pab47/RoadRunner2/README.md

# RoadRunner2
All files related to RoadRunner2, a differential drive rimless wheel

Simulation
  Contains the derivation of simulation of the rimless wheel
    
Code
  Contains Arduino code library and Pi code 
  
Mechanical Design
  Contains solid works files of the different sub-assemblies of the robot.
