pab47/RoadRunner2/Code/README.txt

To install the software, please use the setup.txt file in the SETUP folder.
You will need to have the Arduino IDE installed.

To run the robot, call the following in the terminal:

python3 V5_angle_remote_controller.py
