pab47/RoadRunner2/Simulation/straight_walk_parameter_studies/read_me.rtf

April 17, 2019

1) run driver.m
this calls main to generate the data.

2) run parms_post_processing next to get the trends.
