pab47/RoadRunner2/Simulation/straight_walk_sim_expt/read_me.rtf

April 12, 2019

Comparing simulated data with experimental data for straight line walk for torso angle at 50 degree

Step 1: First run main.m to generate sim_data.mat

Step 2: Next run plotTestData_pab.m
This runs the file plotSimData.m (simulated data) and does experimental plots (this file)
The file plotSimData.m needs sim_data.mat that comes from simulations (step 1 here)

%%%%%%%%%

The columns are

1 time
2 pitch
3 setpoint
4 O drive Current
5 Pitch Rate
6
7 Absolute Velocity
8 Absolute position
9 Bus Voltage
10 Bus Current

Data to show
1) Velocity vs time (7)
2) Absolute position vs time
3) Current versus time

%%%%%%%%%
['curr_time'], ['feedback'], ['angle_cnt'], ['mapped_out'], ['pitchrate'], ['m1pos_deg'], ['m1speed'], ['m1beta'], ['vbus'], ['m1curr'], ['m0pos_deg'],['m0speed']

current time
feedback = what it reading from the imu in degrees
angle_cnt = PID setpoint in degrees
mapped_out = PID output in amps (what the ODrive takes as a desired current)
pitchrate = degrees/s
m1pos_deg
vbus = bus voltage on ODrive = battery voltage
m1 curr = current seen by motor1 (NOT a reliable value; includes imaginary current {the current has real and imaginary parts})

power = column 10 * column 9
O drive current is 4
m1speed
