pab47/RoadRunner2/Simulation/README.md

See descriptions within the files

  - RimlessWheel_Compliant_Derivation.m
	   Derives the sagittal plane model of the rimless wheel with compliant spokes.

  - folder straight_walk_parameter_studies
	  parameter studies 

  - folder straight_walk_sim_expt
	  straight walking compare simulation results with experimental data

  - folder straight_walk
	  straight motion only

  - folder turning_walk
	  turning motion only
