pab47/RoadRunner2/Mechanical_Design/Motor Assembly D.SLDASM

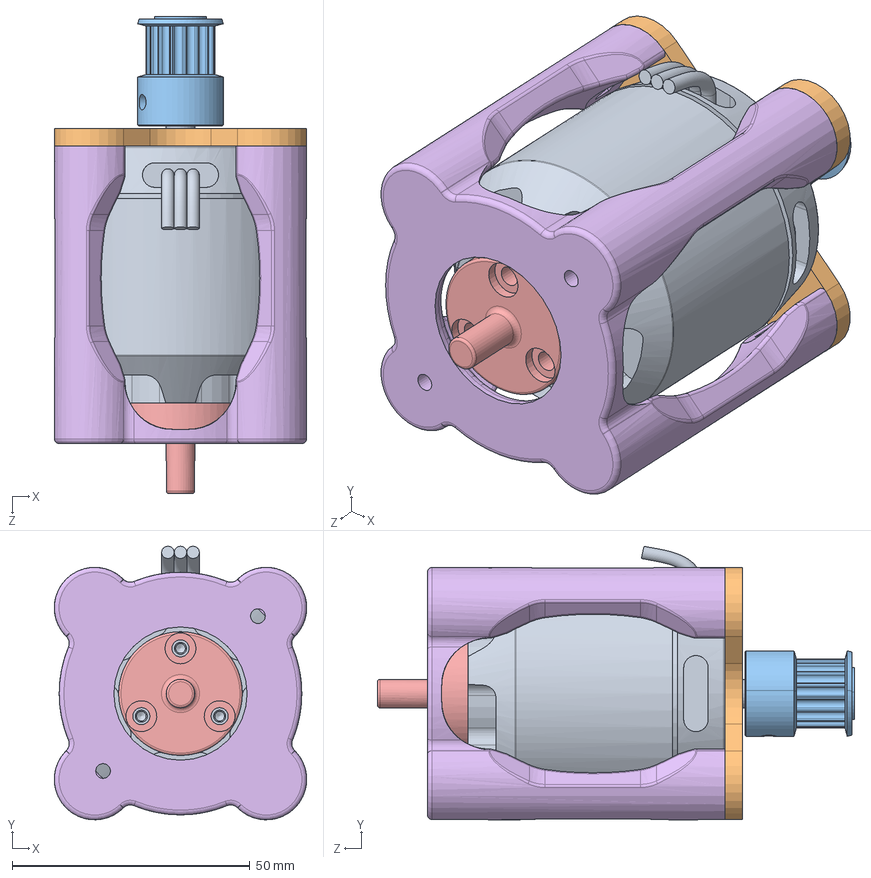
[picture p16: CAD file, 2019-10-29]
Mechanical_Design/Motor Assembly D.SLDASM
53.1 x 57.5 x 100.2 mm
Turnigy 5055 280
Motor Face Plate and Mount
_GPA16MR3090_K_P6_b_2
_SET_SCREW4_3_4 x 2
Screw on Encoder Shaft
Encoder Mount RevC
