pab47/RoadRunner2/Mechanical_Design/Parts/DP4UB-F100A42-B23PE-ACS/74-003.SLDASM

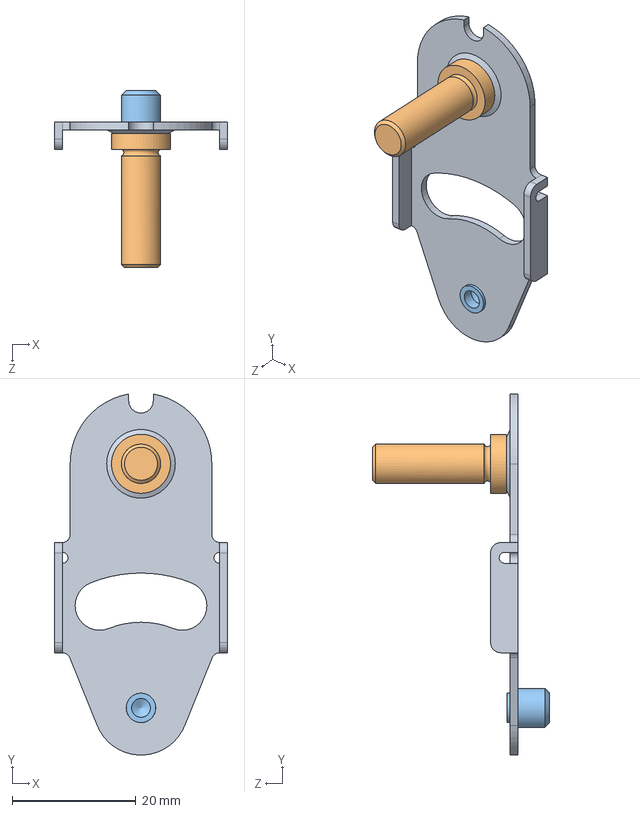
[picture p17: CAD file, 2019-10-29]
Mechanical_Design/Parts/DP4UB-F100A42-B23PE-ACS/74-003.SLDASM
27.9 x 58.2 x 28.6 mm
41-001rA
31-004rA
31-001rA
