pab47/RoadRunner2/Mechanical_Design/Parts/DP4UB-F100A42-B23PE-CWS/DP4UB-F100A42-B23PE-CWS.SLDASM

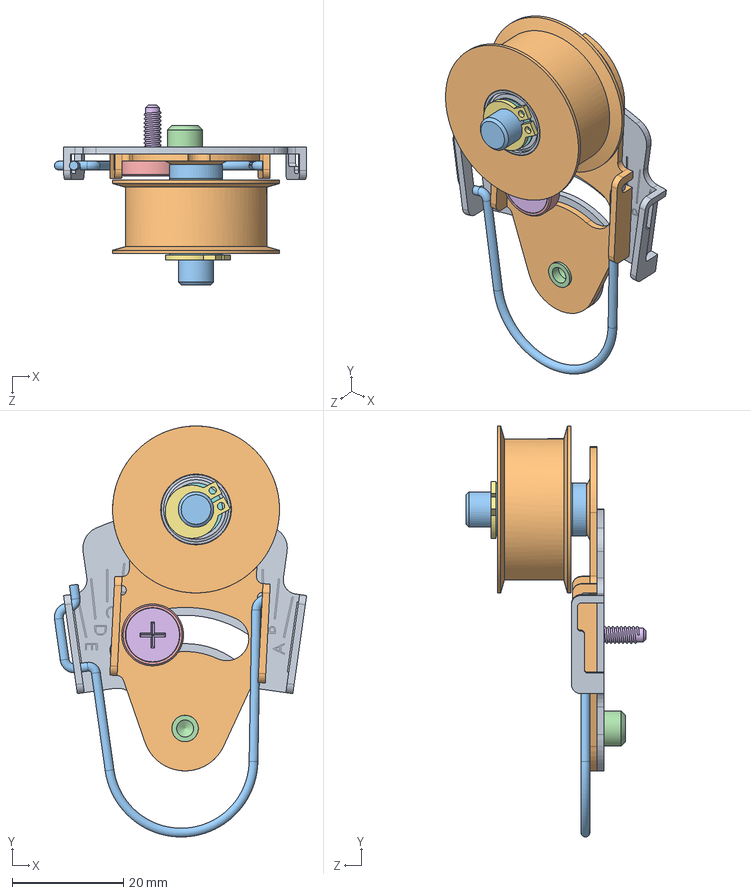
[picture p18: CAD file, 2019-10-29]
Mechanical_Design/Parts/DP4UB-F100A42-B23PE-CWS/DP4UB-F100A42-B23PE-CWS.SLDASM
45.3 x 73.8 x 32.3 mm
41-003rA
41-001rA
31-004rA
31-001rA
31-007rA
81-003rA
84-001rA
83-001rB x 2
88-001rA x 2
54-002compressed
