pab47/RoadRunner2/Mechanical_Design/RR2 Rimless Wheel Subassembly.SLDASM

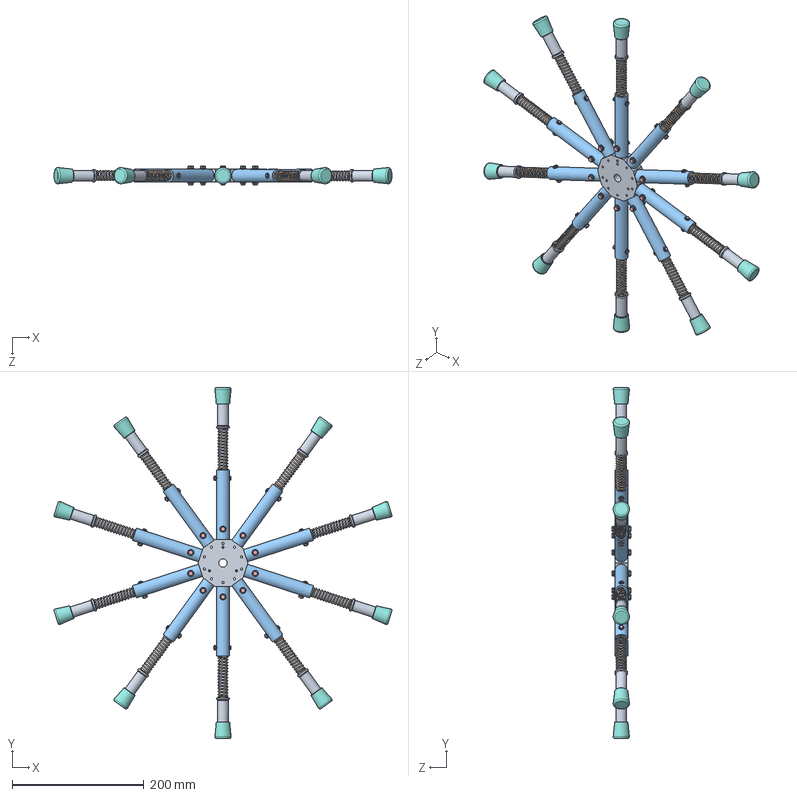
[picture p19: CAD file, 2019-10-29]
Mechanical_Design/RR2 Rimless Wheel Subassembly.SLDASM
513.4 x 533.2 x 28.7 mm
RR2 Leg Rod x 10
RR2 Spring x 10
RR2 Leg Tube x 10
RR2 4 Bushing x 10
RR2 4 Nut x 10
RR2 4 Screw x 10
RR2 4 Washer x 20
RR2 Boot x 10
RR2 Hub Rev B
RR2 Peg x 10
RR2 6 Washer x 20
RR2 6 Nut x 10
RR2 6 Screw x 10
