pab47/RoadRunner2/Mechanical_Design/Parts/Motor Pulley/GPA16MR3090_K_P6.sldasm

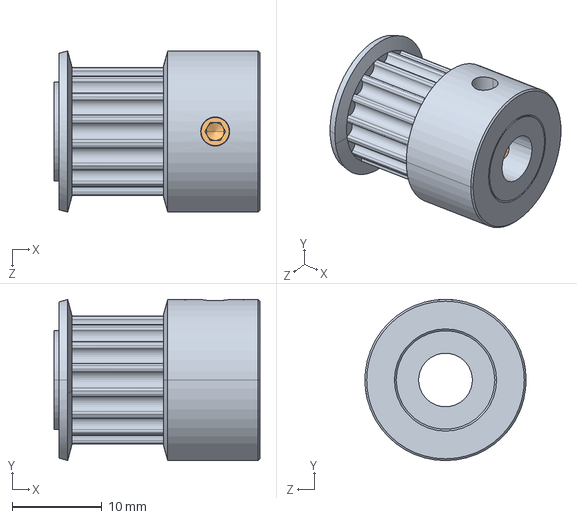
[picture p20: CAD file, 2019-10-29]
Mechanical_Design/Parts/Motor Pulley/GPA16MR3090_K_P6.sldasm
23.0 x 18.0 x 18.0 mm
_GPA16MR3090_K_P6_b_2
_SET_SCREW4_3_4 x 2
