pab47/RoadRunner2/Mechanical_Design/Parts/Shaft Pulley/GPA72MR3090_B_NUF.sldasm

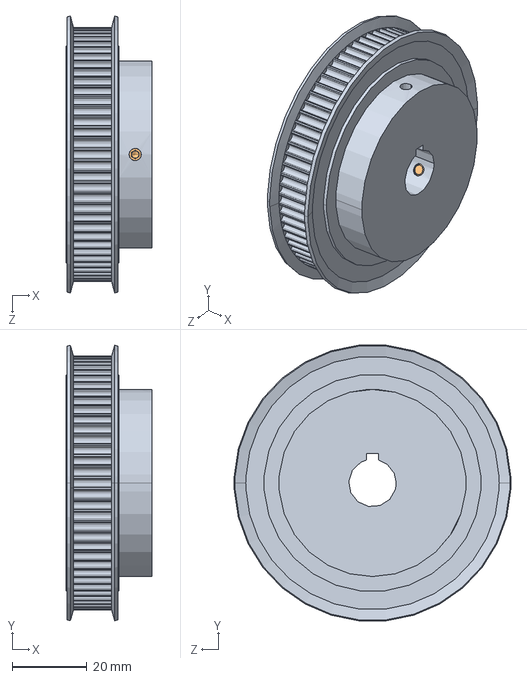
[picture p21: CAD file, 2019-10-29]
Mechanical_Design/Parts/Shaft Pulley/GPA72MR3090_B_NUF.sldasm
23.0 x 73.6 x 74.0 mm
_GPA72MR3090_B_NUF_b_2
_SET_SCREW_8_32_0_328_4 x 2
