pab47/RoadRunner2/Mechanical_Design/Rimless Wheel Subassembly/RR2 Leg Subassembly.SLDASM

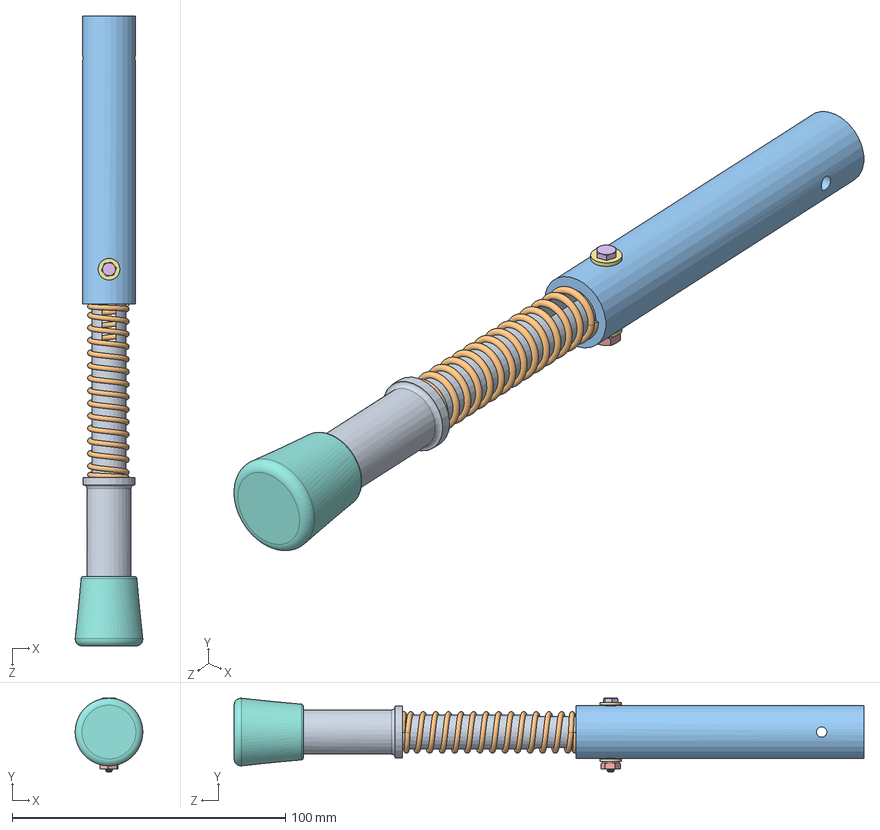
[picture p22: CAD file, 2019-10-29]
Mechanical_Design/Rimless Wheel Subassembly/RR2 Leg Subassembly.SLDASM
24.8 x 26.9 x 230.6 mm
RR2 Leg Rod
RR2 Spring
RR2 Leg Tube
RR2 4 Bushing
RR2 4 Nut
RR2 4 Screw
RR2 4 Washer x 2
RR2 Boot
