pab47/RoadRunner2/Mechanical_Design/Rimless Wheel Subassembly/RR2 Hub Subassembly.SLDASM

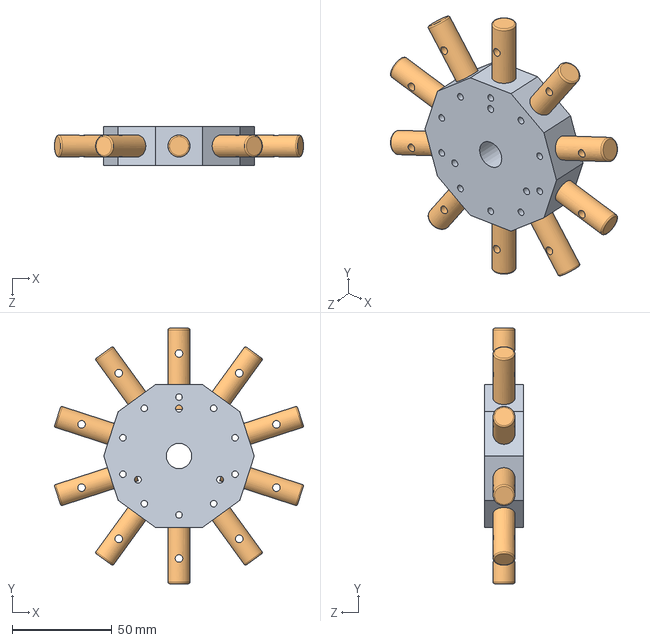
[picture p23: CAD file, 2019-10-29]
Mechanical_Design/Rimless Wheel Subassembly/RR2 Hub Subassembly.SLDASM
125.0 x 128.3 x 19.6 mm
RR2 Hub Rev B
RR2 Peg x 10
