pab47/RoadRunner2/Mechanical_Design/Motor Assem Parts/Motor Face Plate and Mount.SLDPRT

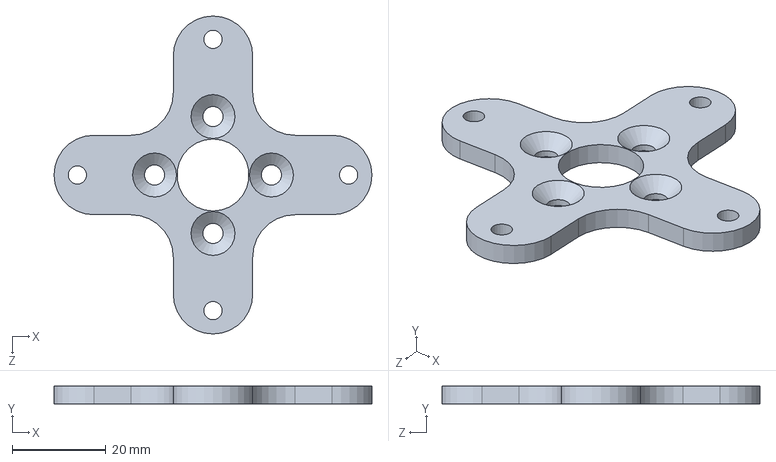
[picture p24: CAD file, 2019-10-29]
Mechanical_Design/Motor Assem Parts/Motor Face Plate and Mount.SLDPRT
68.0 x 3.75 x 68.0 mm
