pab47/RoadRunner2/Mechanical_Design/Parts/Misc/Encoder Mount Mirrored.SLDPRT

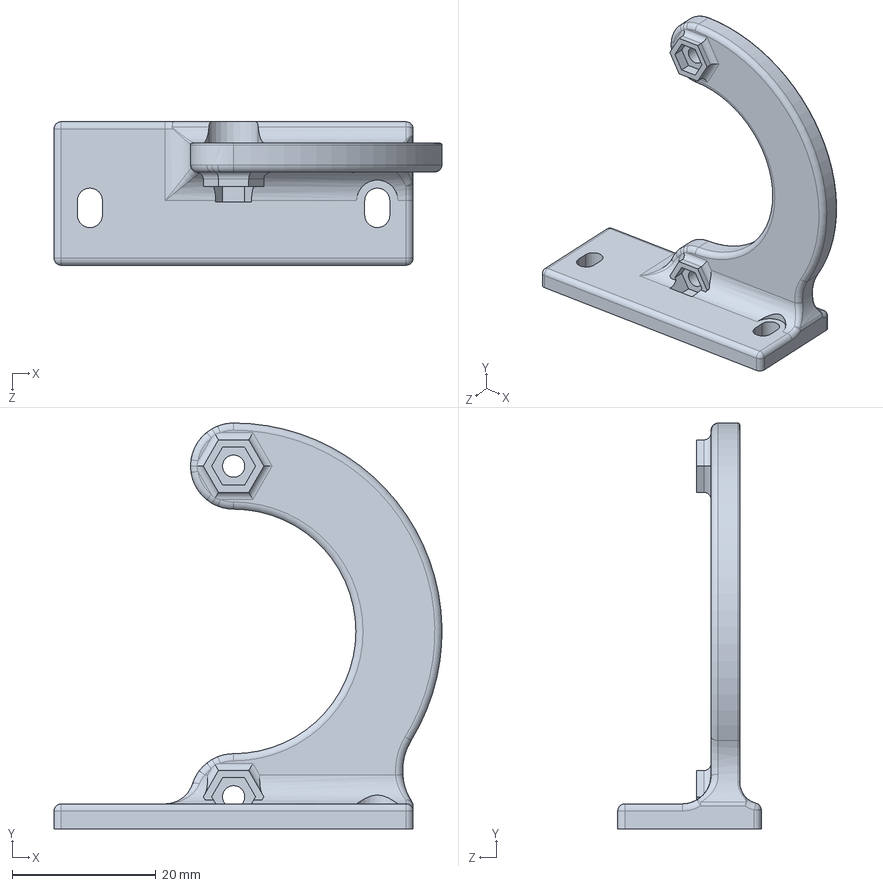
[picture p25: CAD file, 2019-10-29]
Mechanical_Design/Parts/Misc/Encoder Mount Mirrored.SLDPRT
54.0 x 56.5 x 20.0 mm
