pab47/RoadRunner2/Mechanical_Design/Parts/Turnigy 6S 3600mAh.SLDPRT

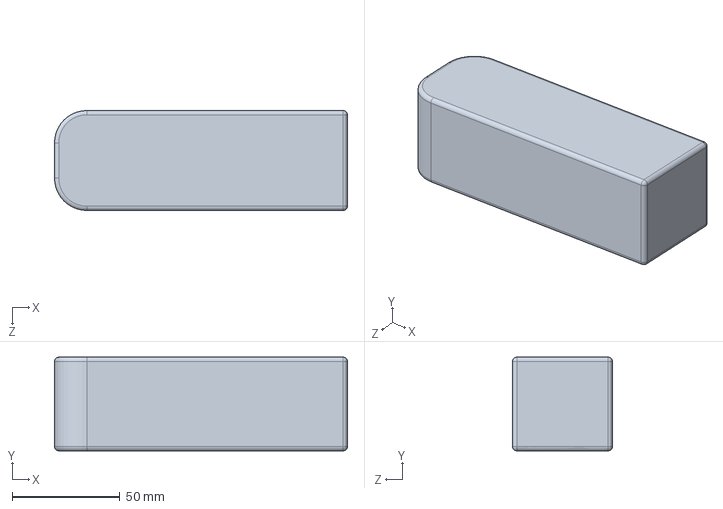
[picture p26: CAD file, 2019-10-29]
Mechanical_Design/Parts/Turnigy 6S 3600mAh.SLDPRT
136.0 x 43.5 x 46.4 mm
