pab47/RoadRunner2/Mechanical_Design/Rimless Wheel Subassembly/RR2 Leg Tube.SLDPRT

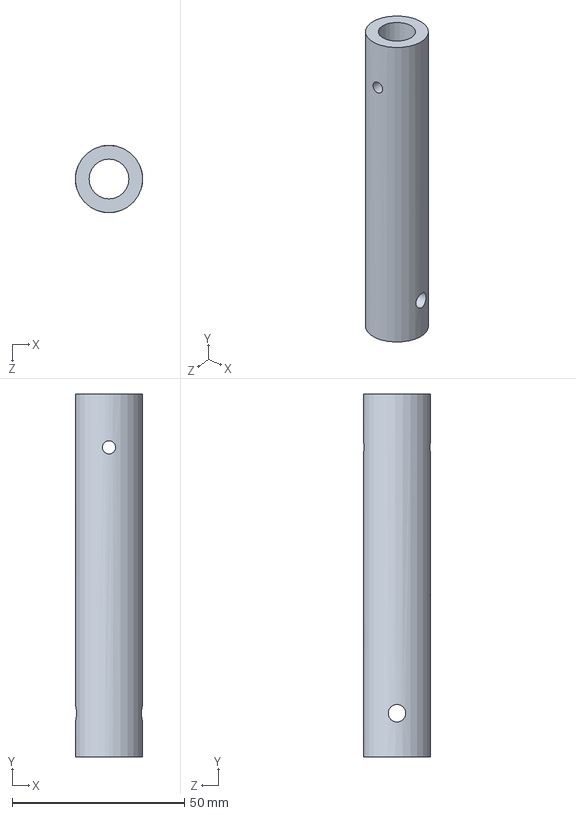
[picture p27: CAD file, 2019-10-29]
Mechanical_Design/Rimless Wheel Subassembly/RR2 Leg Tube.SLDPRT
19.6 x 105.4 x 19.6 mm
