pab47/RoadRunner2/Mechanical_Design/Motor Assem Parts/Turnigy 5055 280.SLDPRT

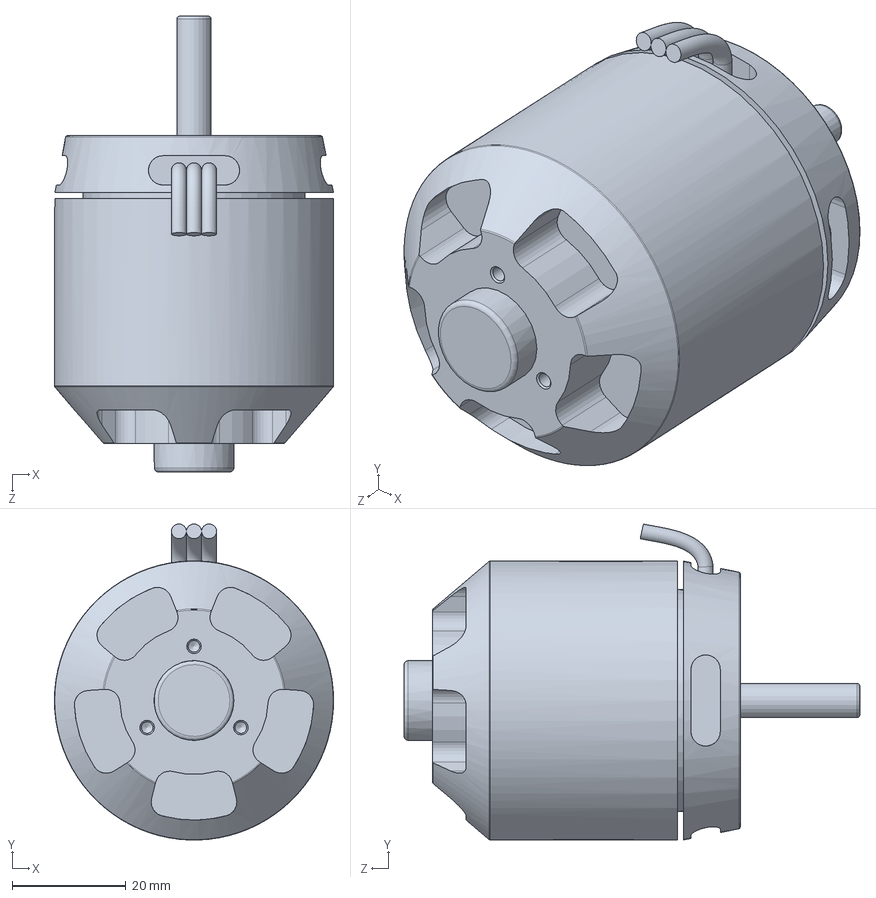
[picture p28: CAD file, 2019-10-29]
Mechanical_Design/Motor Assem Parts/Turnigy 5055 280.SLDPRT
49.0 x 55.5 x 80.0 mm
