pab47/RoadRunner2/Mechanical_Design/Parts/DP4UB-F100A42-B23PE-ACS/81-003rA.SLDPRT

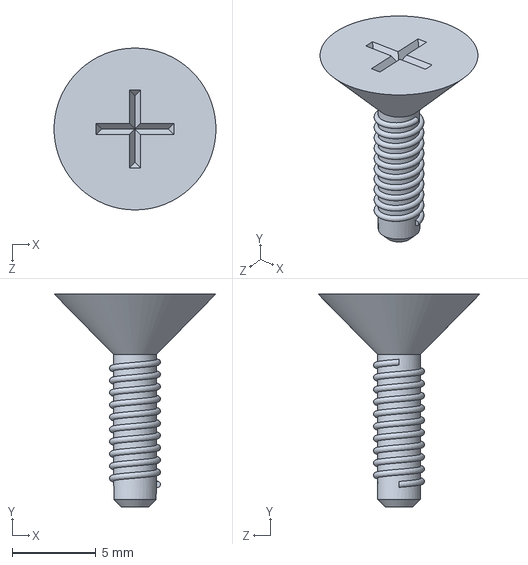
[picture p29: CAD file, 2019-10-29]
Mechanical_Design/Parts/DP4UB-F100A42-B23PE-ACS/81-003rA.SLDPRT
9.64 x 12.7 x 9.65 mm
