pab47/RoadRunner2/Mechanical_Design/Parts/RoadRunner Body RevBb.SLDPRT

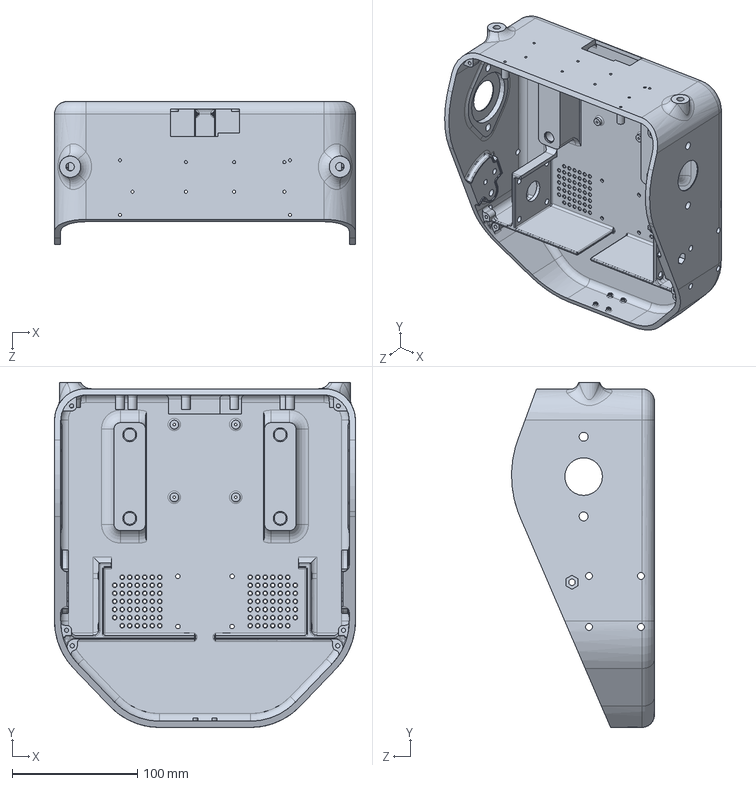
[picture p30: CAD file, 2019-10-29]
Mechanical_Design/Parts/RoadRunner Body RevBb.SLDPRT
240.0 x 275.0 x 114.0 mm
