pab47/RoadRunner2/Mechanical_Design/Parts/DP4UB-F100A42-B23PE-ACS/41-001rA.SLDPRT

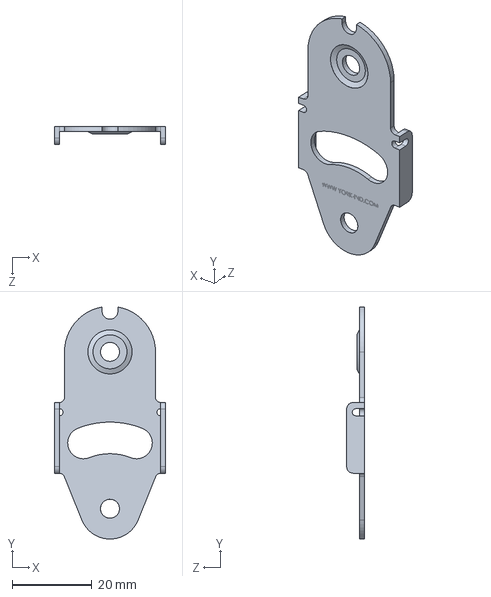
[picture p31: CAD file, 2019-10-29]
Mechanical_Design/Parts/DP4UB-F100A42-B23PE-ACS/41-001rA.SLDPRT
27.9 x 58.2 x 4.45 mm
