pab47/RoadRunner2/Mechanical_Design/Parts/E-Stop 16mm.SLDPRT

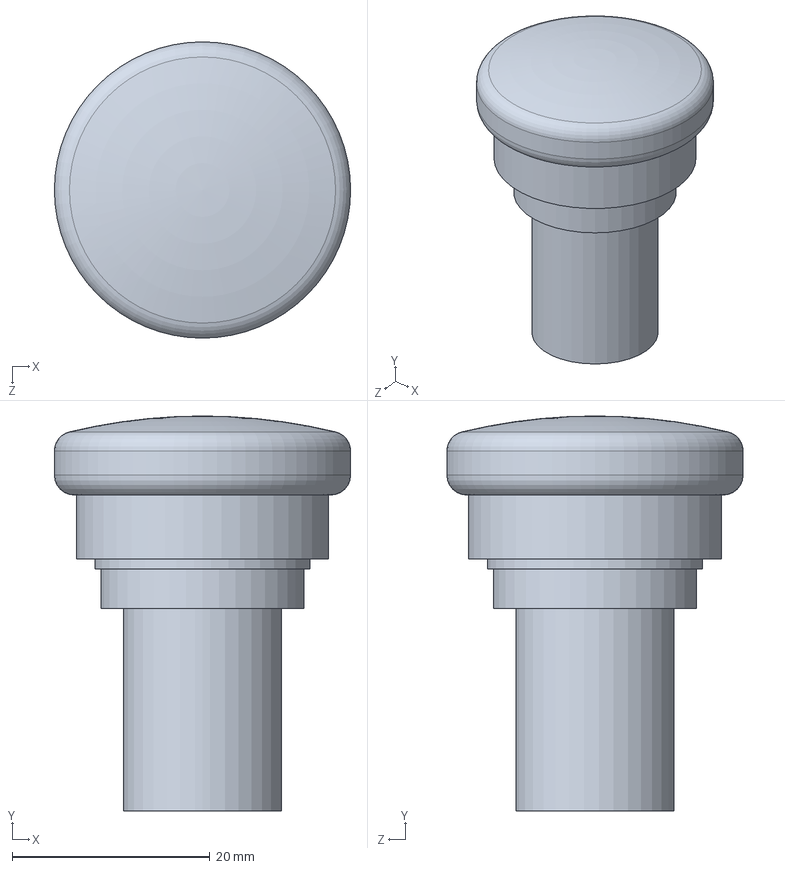
[picture p32: CAD file, 2019-10-29]
Mechanical_Design/Parts/E-Stop 16mm.SLDPRT
30.0 x 40.0 x 30.0 mm
