pab47/RoadRunner2/Mechanical_Design/Parts/DP4UB-F100A42-B23PE-ACS/88-001rA.SLDPRT

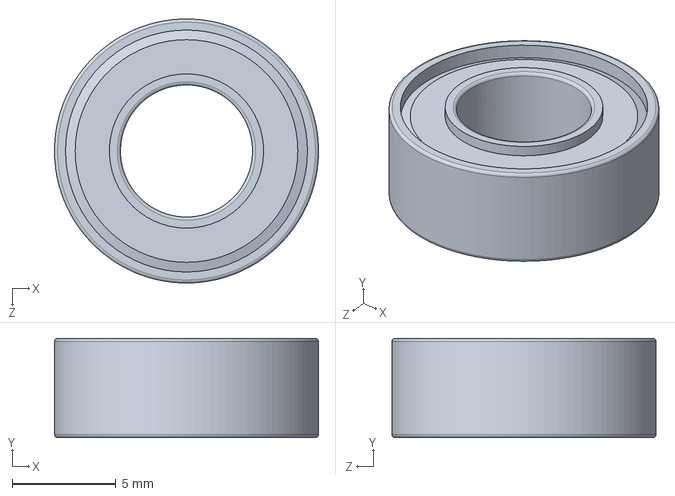
[picture p33: CAD file, 2019-10-29]
Mechanical_Design/Parts/DP4UB-F100A42-B23PE-ACS/88-001rA.SLDPRT
12.7 x 4.78 x 12.7 mm
