pab47/RoadRunner2/Mechanical_Design/Parts/Misc/E-Stop Cover.SLDPRT

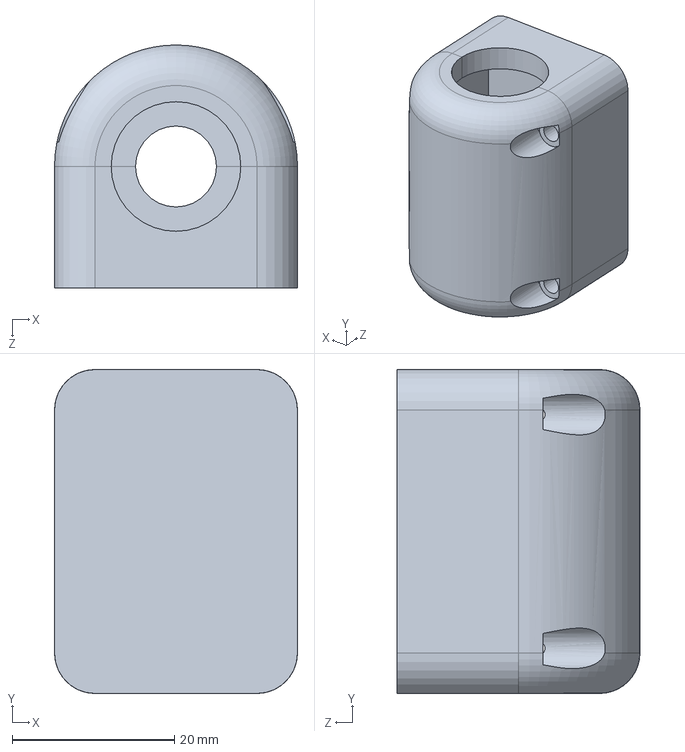
[picture p34: CAD file, 2019-10-29]
Mechanical_Design/Parts/Misc/E-Stop Cover.SLDPRT
30.0 x 40.0 x 30.0 mm
