pab47/RoadRunner2/Mechanical_Design/Parts/Misc/Encoder Mount RevC.SLDPRT

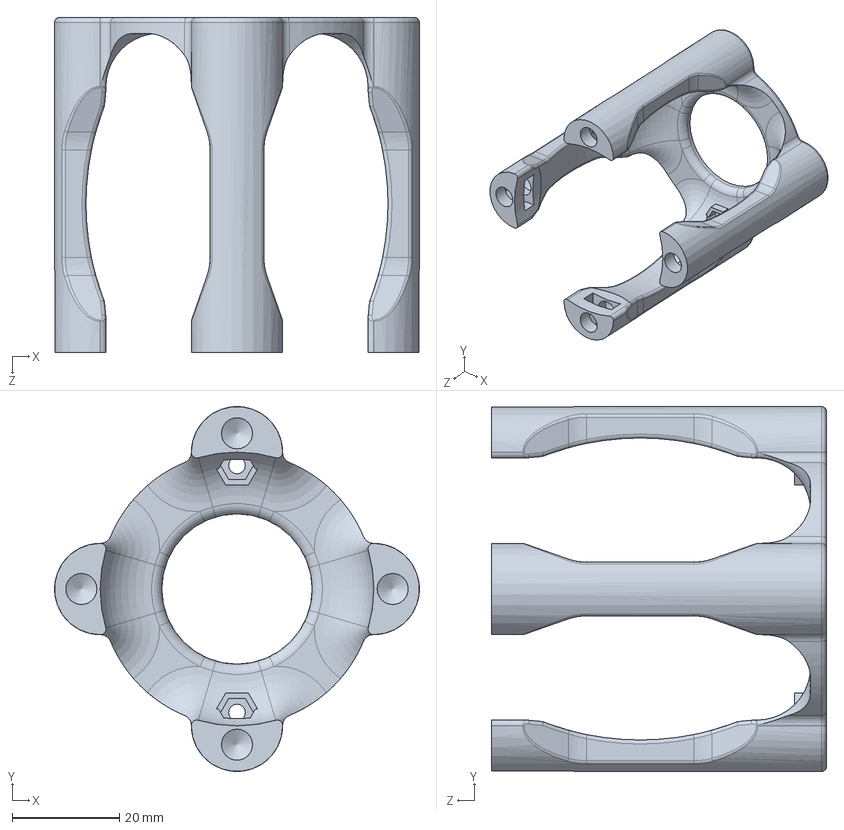
[picture p35: CAD file, 2019-10-29]
Mechanical_Design/Parts/Misc/Encoder Mount RevC.SLDPRT
68.0 x 68.0 x 62.5 mm
