pab47/RoadRunner2/Mechanical_Design/Rimless Wheel Subassembly/RR2 Leg Rod.SLDPRT

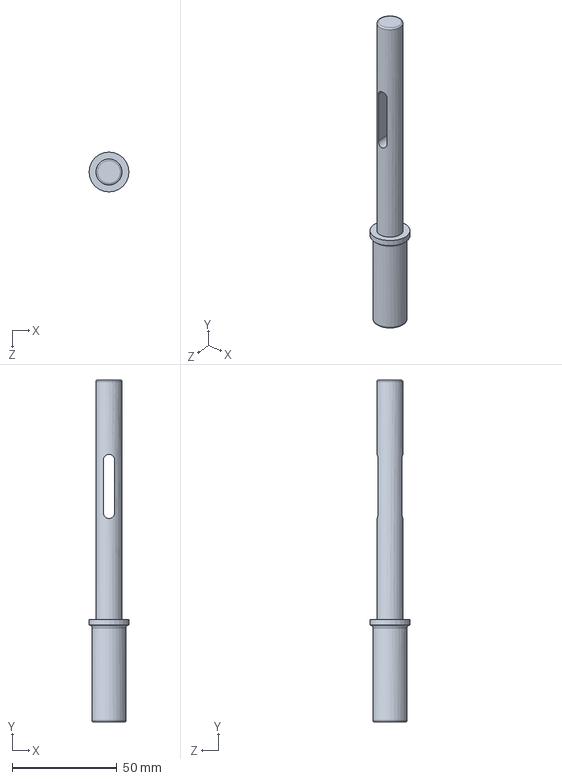
[picture p36: CAD file, 2019-10-29]
Mechanical_Design/Rimless Wheel Subassembly/RR2 Leg Rod.SLDPRT
19.1 x 163.3 x 19.1 mm
