pab47/RoadRunner2/Mechanical_Design/Parts/DP4UB-F100A42-B23PE-ACS/31-004rA.SLDPRT

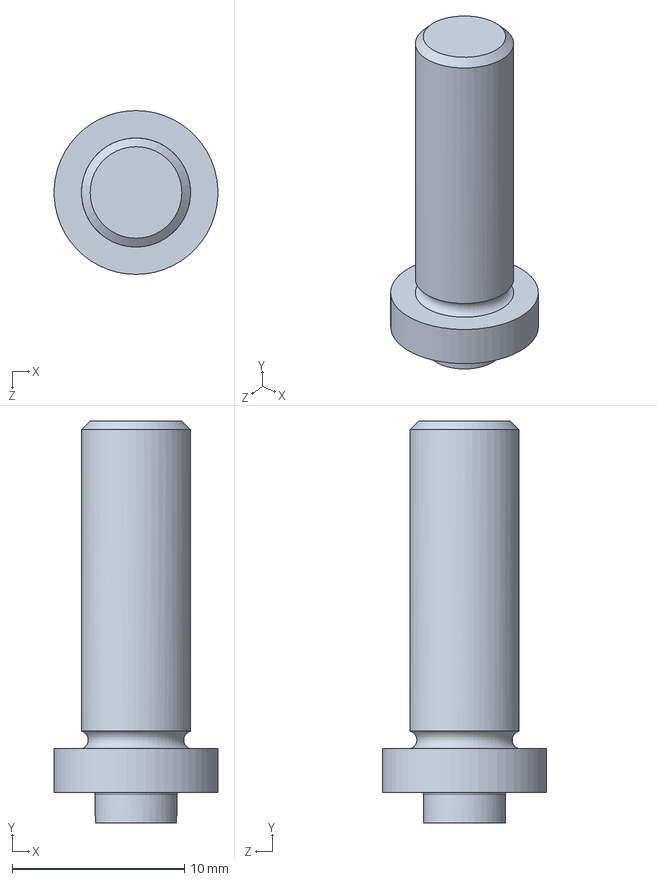
[picture p37: CAD file, 2019-10-29]
Mechanical_Design/Parts/DP4UB-F100A42-B23PE-ACS/31-004rA.SLDPRT
9.51 x 23.4 x 9.53 mm
