pab47/RoadRunner2/Mechanical_Design/Rimless Wheel Subassembly/RR2 Boot.SLDPRT

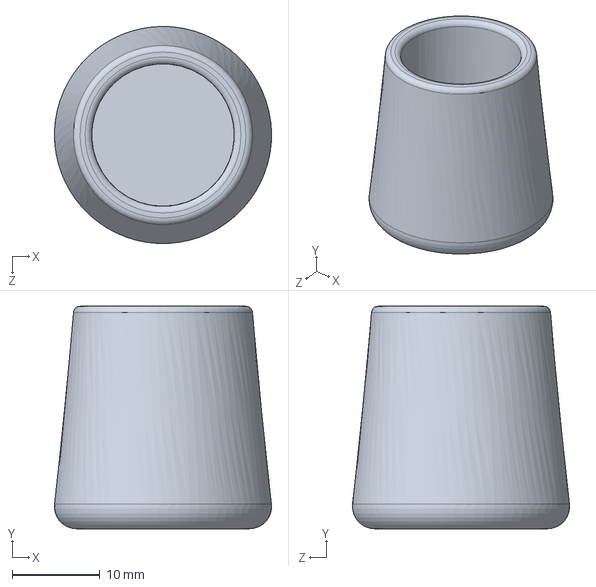
[picture p38: CAD file, 2019-10-29]
Mechanical_Design/Rimless Wheel Subassembly/RR2 Boot.SLDPRT
24.8 x 25.4 x 24.8 mm
