pab47/RoadRunner2/Mechanical_Design/Parts/DP4UB-F100A42-B23PE-ACS/35-004.SLDPRT

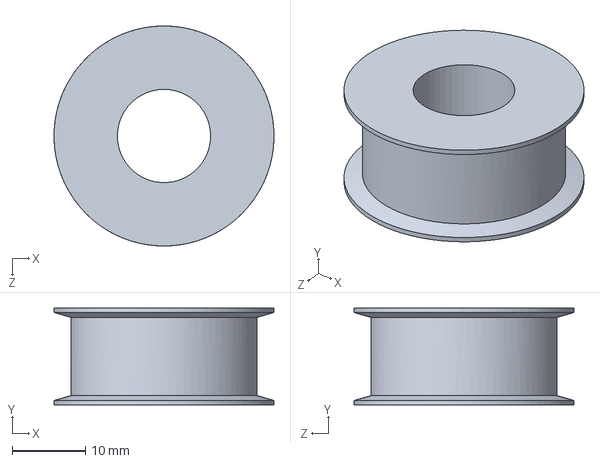
[picture p39: CAD file, 2019-10-29]
Mechanical_Design/Parts/DP4UB-F100A42-B23PE-ACS/35-004.SLDPRT
30.0 x 13.2 x 30.0 mm
