pab47/RoadRunner2/Mechanical_Design/Rimless Wheel Subassembly/RR2 Peg.SLDPRT

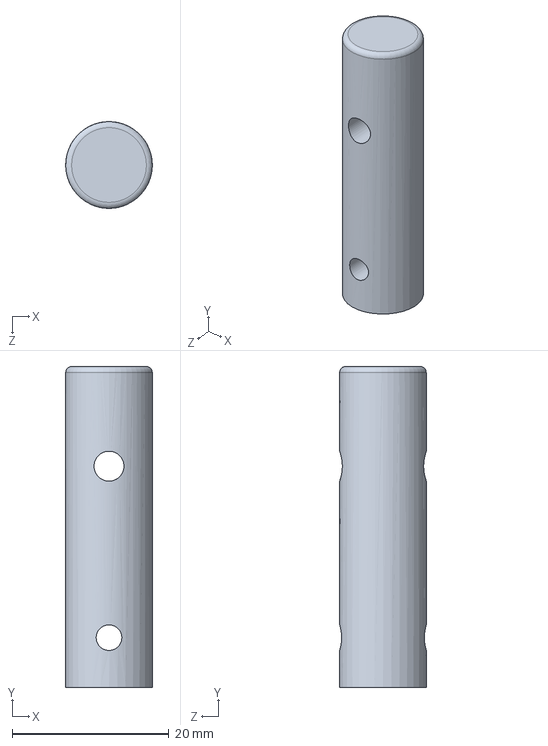
[picture p40: CAD file, 2019-10-29]
Mechanical_Design/Rimless Wheel Subassembly/RR2 Peg.SLDPRT
11.0 x 40.9 x 11.0 mm
