pab47/RoadRunner2/Mechanical_Design/Parts/DP4UB-F100A42-B23PE-ACS/31-007rA.SLDPRT

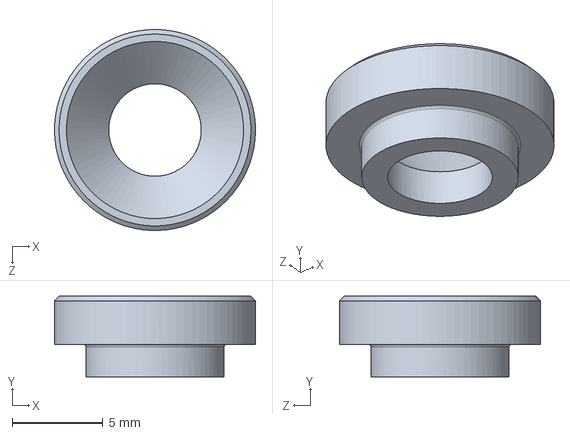
[picture p41: CAD file, 2019-10-29]
Mechanical_Design/Parts/DP4UB-F100A42-B23PE-ACS/31-007rA.SLDPRT
11.1 x 4.45 x 11.1 mm
