pab47/RoadRunner2/Mechanical_Design/Parts/DP4UB-F100A42-B23PE-ACS/41-003rA.SLDPRT

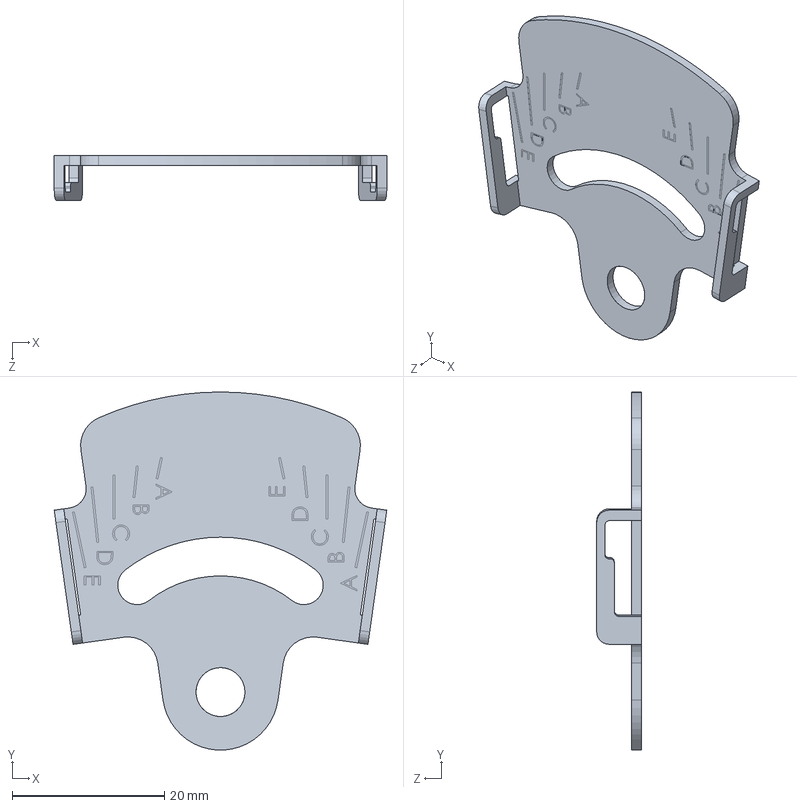
[picture p42: CAD file, 2019-10-29]
Mechanical_Design/Parts/DP4UB-F100A42-B23PE-ACS/41-003rA.SLDPRT
43.6 x 47.0 x 5.87 mm
