pab47/RoadRunner2/Mechanical_Design/Parts/DP4UB-F100A42-B23PE-ACS/54-002compressed.SLDPRT

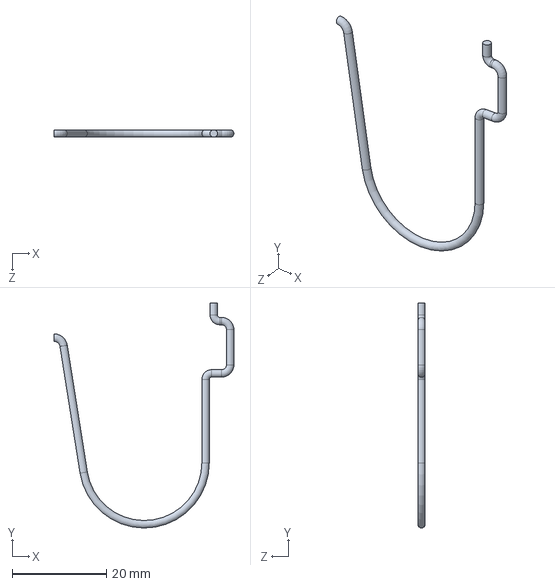
[picture p43: CAD file, 2019-10-29]
Mechanical_Design/Parts/DP4UB-F100A42-B23PE-ACS/54-002compressed.SLDPRT
38.1 x 47.7 x 1.59 mm
