pab47/RoadRunner2/Mechanical_Design/Parts/DP4UB-F100A42-B23PE-ACS/83-001rB.SLDPRT

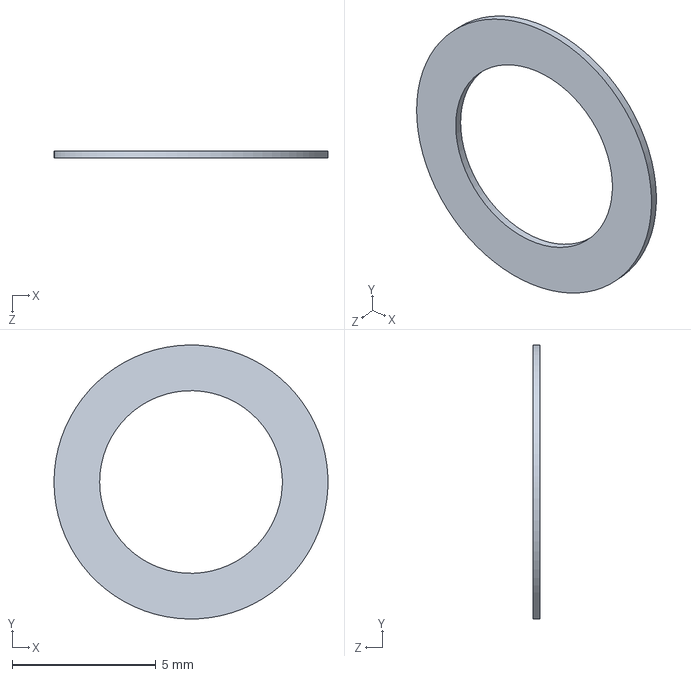
[picture p44: CAD file, 2019-10-29]
Mechanical_Design/Parts/DP4UB-F100A42-B23PE-ACS/83-001rB.SLDPRT
9.53 x 9.52 x 0.254 mm
