pab47/RoadRunner2/Mechanical_Design/Parts/DP4UB-F100A42-B23PE-ACS/84-001rA.SLDPRT

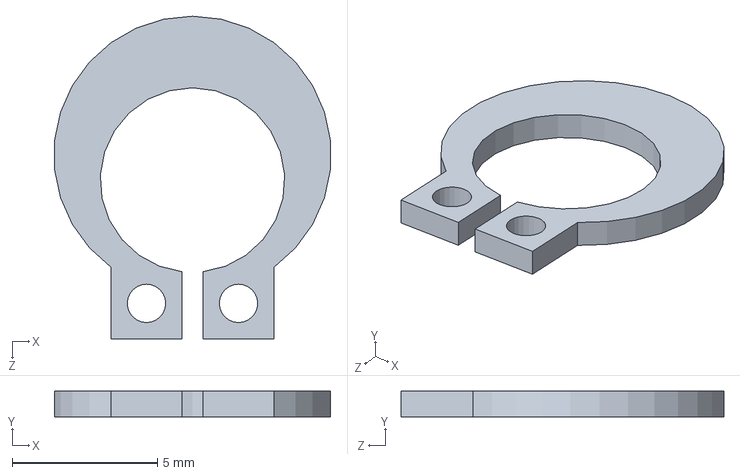
[picture p45: CAD file, 2019-10-29]
Mechanical_Design/Parts/DP4UB-F100A42-B23PE-ACS/84-001rA.SLDPRT
9.50 x 0.889 x 11.1 mm
