pab47/RoadRunner2/Mechanical_Design/Rimless Wheel Subassembly/RR2 Hub Rev B.SLDPRT

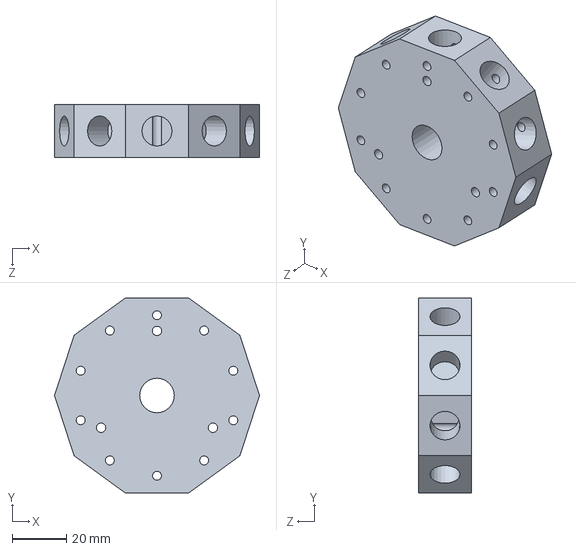
[picture p46: CAD file, 2019-10-29]
Mechanical_Design/Rimless Wheel Subassembly/RR2 Hub Rev B.SLDPRT
75.6 x 71.9 x 19.6 mm
