pab47/RoadRunner2/Mechanical_Design/Parts/DP4UB-F100A42-B23PE-ACS/31-001rA.SLDPRT

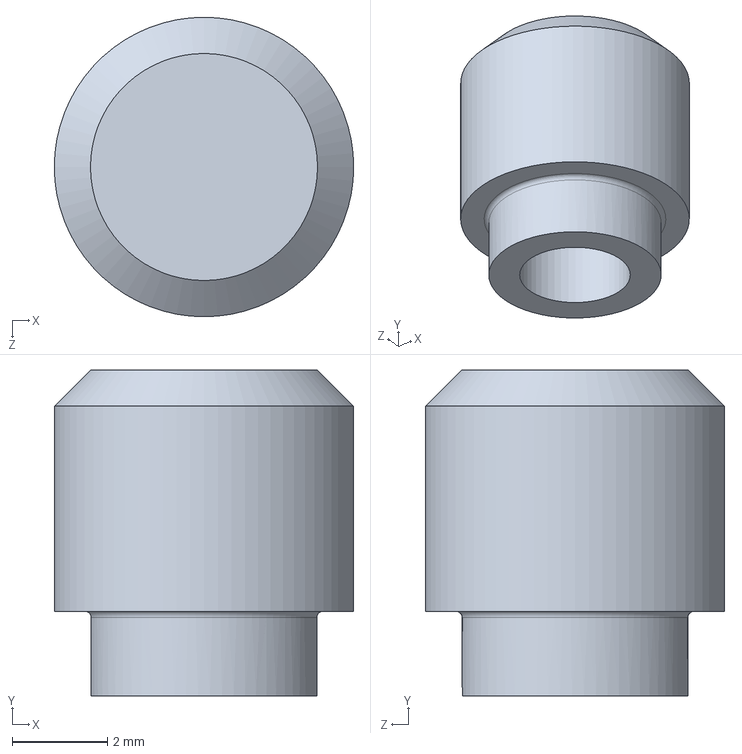
[picture p47: CAD file, 2019-10-29]
Mechanical_Design/Parts/DP4UB-F100A42-B23PE-ACS/31-001rA.SLDPRT
6.30 x 6.86 x 6.30 mm
