pab47/RoadRunner2/Mechanical_Design/Rimless Wheel Subassembly/RR2 4 Bushing.SLDPRT

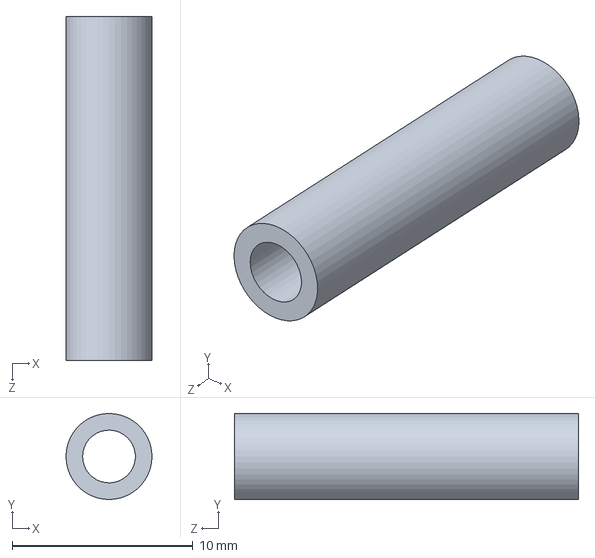
[picture p48: CAD file, 2019-10-29]
Mechanical_Design/Rimless Wheel Subassembly/RR2 4 Bushing.SLDPRT
4.76 x 4.76 x 19.1 mm
