pab47/RoadRunner2/Mechanical_Design/Rimless Wheel Subassembly/RR2 Spring.SLDPRT

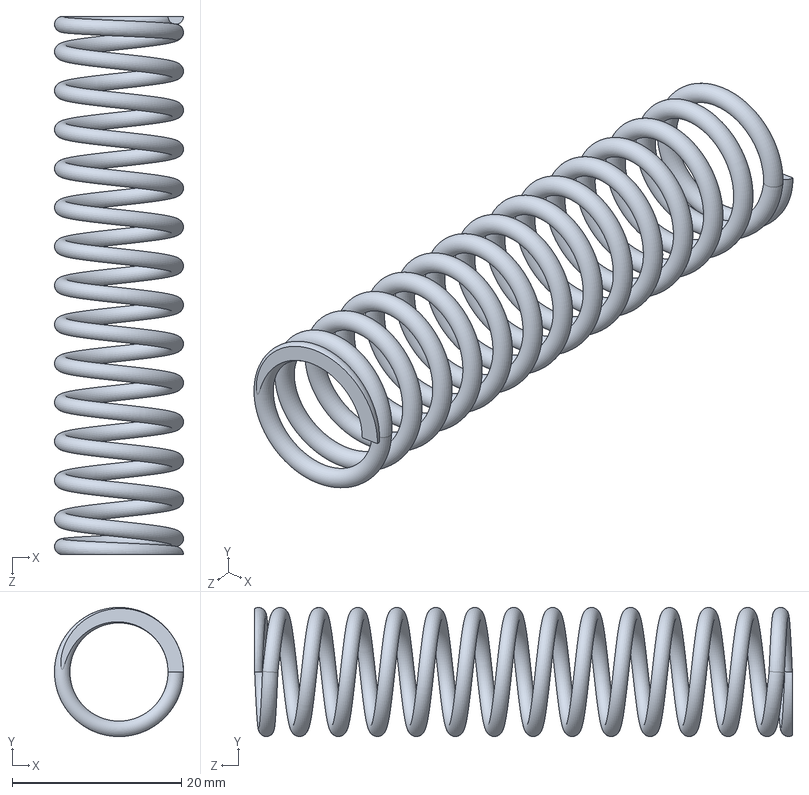
[picture p49: CAD file, 2019-10-29]
Mechanical_Design/Rimless Wheel Subassembly/RR2 Spring.SLDPRT
15.2 x 15.2 x 63.5 mm
