pab47/RoadRunner2/(list of files, cad)

Other CAD files:
Mechanical_Design/Parts/DP4UB-F100A42-B23PE-ACS/DP4UB-F100A42-B23PE-ACS.SLDASM
Mechanical_Design/Parts/CUI_AMT102-2048-I6000-W/CUI_amt-102-wide-base-rev-j.sldprt
Mechanical_Design/Parts/Motor Pulley/_GPA16MR3090_K_P6_b_2.sldprt
Mechanical_Design/Parts/CUI_AMT102-2048-I6000-W/CUI_amt-sleeve-rev-d(6 mm).sldprt
Mechanical_Design/Parts/Shaft Pulley/_GPA72MR3090_B_NUF_b_2.sldprt
Mechanical_Design/Parts/CUI_AMT102-2048-I6000-W/CUI_receiver-board.sldprt
Mechanical_Design/Parts/Misc/Encoder Mount.SLDPRT
Mechanical_Design/Parts/CUI_AMT102-2048-I6000-W/CUI_amt10x-shaft-adaptor-rev-e.sldprt
Mechanical_Design/Parts/CUI_AMT102-2048-I6000-W/CUI_amt-hub-bottom-rev-b.sldprt
Mechanical_Design/Parts/CUI_AMT102-2048-I6000-W/CUI_amt-102-top-cover-rev-h.sldprt
Mechanical_Design/Parts/CUI_AMT102-2048-I6000-W/CUI_amt-hub-top-rev-d1.sldprt
Mechanical_Design/Parts/CUI_AMT102-2048-I6000-W/CUI_transmitter-board amt10(amt-102).sldprt
Mechanical_Design/Parts/CUI_AMT102-2048-I6000-W/CUI_rotor-board-rev f.sldprt
Mechanical_Design/Parts/McMaster/1497K800_FULLY KEYED 1045 STEEL DRIVE SHAFT.SLDPRT
Mechanical_Design/Parts/McMaster/3014T450_STEEL EYEBOLT WITH SHOULDER - FOR LIFTING.SLDPRT
Mechanical_Design/Parts/McMaster/5909K310_THRUST NEEDLE-ROLLER BEARING.SLDPRT
Mechanical_Design/Parts/McMaster/5909K440_THRUST NEEDLE-ROLLER BEARING.SLDPRT
Mechanical_Design/Parts/McMaster/5913K610_LOW-PROFILE MOUNTED BALL BEARING.SLDPRT
Mechanical_Design/Parts/McMaster/5913K710_LOW-PROFILE MOUNTED BALL BEARING.SLDPRT
Mechanical_Design/Parts/McMaster/6435K140_ONE-PIECE CLAMP-ON SHAFT COLLAR.SLDPRT
Mechanical_Design/Parts/McMaster/7814K160_MULTIPURPOSE THRUST BEARING.SLDPRT
Mechanical_Design/Parts/McMaster/90185A540_ZINC-PLATED STEEL SQUARE NECK CARRIAGE BOLT.SLDPRT
Mechanical_Design/Parts/McMaster/90631A411_LOW-STRENGTH STEEL NYLON-INSERT LOCKNUT.SLDPRT
Mechanical_Design/Parts/McMaster/90695A033_CLASS 04 STEEL THIN HEX NUT - DIN 439B.SLDPRT
Mechanical_Design/Parts/McMaster/91239A222_CLASS 10.9 STL BUTTON-HEAD SOCKET CAP SCREW.SLDPRT
Mechanical_Design/Parts/McMaster/91255A580_ALLOY STEEL BUTTON-HEAD SOCKET CAP SCREW.SLDPRT
Mechanical_Design/Parts/McMaster/91290A125_BLACK-OXIDE CLASS 12.9 SOCKET HEAD CAP SCREW.SLDPRT
Mechanical_Design/Parts/McMaster/92141A029_TYPE 18-8 STAINLESS STEEL FLAT WASHER.SLDPRT
Mechanical_Design/Parts/McMaster/94615A117_BRASS PRESS-FIT EXPANSION INSERT FOR PLASTICS.SLDPRT
Mechanical_Design/Parts/McMaster/94895A029_ZINC YELLOW-CHROMATE PLATED STEEL HEX NUT.SLDPRT
Mechanical_Design/Parts/McMaster/9684T100_FLANGED SHAFT COLLAR WITH MOUNTING HOLES.SLDPRT
Mechanical_Design/Parts/McMaster/97135A210_GRADE 8 STEEL NYLON-INSERT LOCKNUT.SLDPRT
Mechanical_Design/Parts/Misc/Screw on Encoder Shaft.SLDPRT
Mechanical_Design/Parts/Motor Pulley/_SET_SCREW4_3_4.sldprt
Mechanical_Design/Parts/Shaft Pulley/_SET_SCREW_8_32_0_328_4.sldprt
Mechanical_Design/Rimless Wheel Subassembly/RR2 4 Nut.SLDPRT
Mechanical_Design/Rimless Wheel Subassembly/RR2 4 Screw.SLDPRT
Mechanical_Design/Rimless Wheel Subassembly/RR2 4 Washer.SLDPRT
Mechanical_Design/Rimless Wheel Subassembly/RR2 6 Nut.SLDPRT
Mechanical_Design/Rimless Wheel Subassembly/RR2 6 Screw.SLDPRT
Mechanical_Design/Rimless Wheel Subassembly/RR2 6 Washer.SLDPRT
