pab47/RoadRunner2/Simulation/straight_walk_parameter_studies/results/alpha.pdf

10 | 20 | 30 | 40 | 50 | 60 | 70 | 80 | 90

0.76

0.78

0.8

### Speed (m/s)

10 | 20 | 30 | 40 | 50 | 60 | 70 | 80 | 90

1.57

1.58

1.59

1.6

### Torque (Nm)

10 | 20 | 30 | 40 | 50 | 60 | 70 | 80 | 90

4.5

4.6

4.7

4.8

### Power (W)

10 | 20 | 30 | 40 | 50 | 60 | 70 | 80 | 90

### alpha

0.0878

0.088

0.0882

0.0884

### TCOT motor
