pab47/RoadRunner2/Simulation/straight_walk_parameter_studies/results/com.pdf

0.02 | 0.04 | 0.06 | 0.08 | 0.1 | 0.12 | 0.14 | 0.16 | 0.18 | 0.2 012

### Speed (m/s)

0.02 | 0.04 | 0.06 | 0.08 | 0.1 | 0.12 | 0.14 | 0.16 | 0.18 | 0.2 024

### Torque (Nm)

0.02 | 0.04 | 0.06 | 0.08 | 0.1 | 0.12 | 0.14 | 0.16 | 0.18 | 0.2 0

10

20

30

### Power (W)

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

### com

0

0.1

0.2

0.3

### TCOT motor
