pab47/RoadRunner2/Simulation/straight_walk_parameter_studies/results/mWheel.pdf

2 | 2.5
3 | 3.5
4 | 4.5
5 | 5.5

6

0.4

0.6

0.81

### Speed (m/s)

2 | 2.5
3 | 3.5
4 | 4.5
5 | 5.5

6

1.5

1.6

1.7

1.8

### Torque (Nm)

2 | 2.5
3 | 3.5
4 | 4.5
5 | 5.5

6

3.54

4.55

### Power (W)

2 | 2.5
3 | 3.5
4 | 4.5
5 | 5.5

6

### mWheel

0.06

0.08

0.1

### TCOT motor
