pab47/RoadRunner2/Simulation/straight_walk_parameter_studies/results/spokes.pdf

8 | 10 | 12 | 14 | 16 | 18 | 20

0.6

0.81

1.2

### Speed (m/s)

8 | 10 | 12 | 14 | 16 | 18 | 20

0.51

1.52

### Torque (Nm)

8 | 10 | 12 | 14 | 16 | 18 | 20

3.54

4.55

### Power (W)

8 | 10 | 12 | 14 | 16 | 18 | 20

### spokes

0.04

0.06

0.08

0.1

### TCOT motor
