pab47/RoadRunner2/Simulation/straight_walk_parameter_studies/results/stiffness.pdf

500 | 1000 | 1500 | 2000 | 2500 | 3000 | 3500 | 4000

0.7852

0.785201

0.785202

0.785203

### Speed (m/s)

500 | 1000 | 1500 | 2000 | 2500 | 3000 | 3500 | 4000

1.580505

1.580506

1.580507

### Torque (Nm)

500 | 1000 | 1500 | 2000 | 2500 | 3000 | 3500 | 4000

4.675805

4.67581

4.675815

### Power (W)

500 | 1000 | 1500 | 2000 | 2500 | 3000 | 3500 | 4000

### stiffness

0.08792055

0.0879206

0.08792065

0.0879207
