pab47/RoadRunner2/Simulation/straight_walk_sim_expt/results/absolute_speed.pdf

-2.5

-2

-1.5

-1

-0.5

0

Absolute angular speed (rad/s)
