pab47/RoadRunner2/Simulation/straight_walk_sim_expt/results/current.pdf

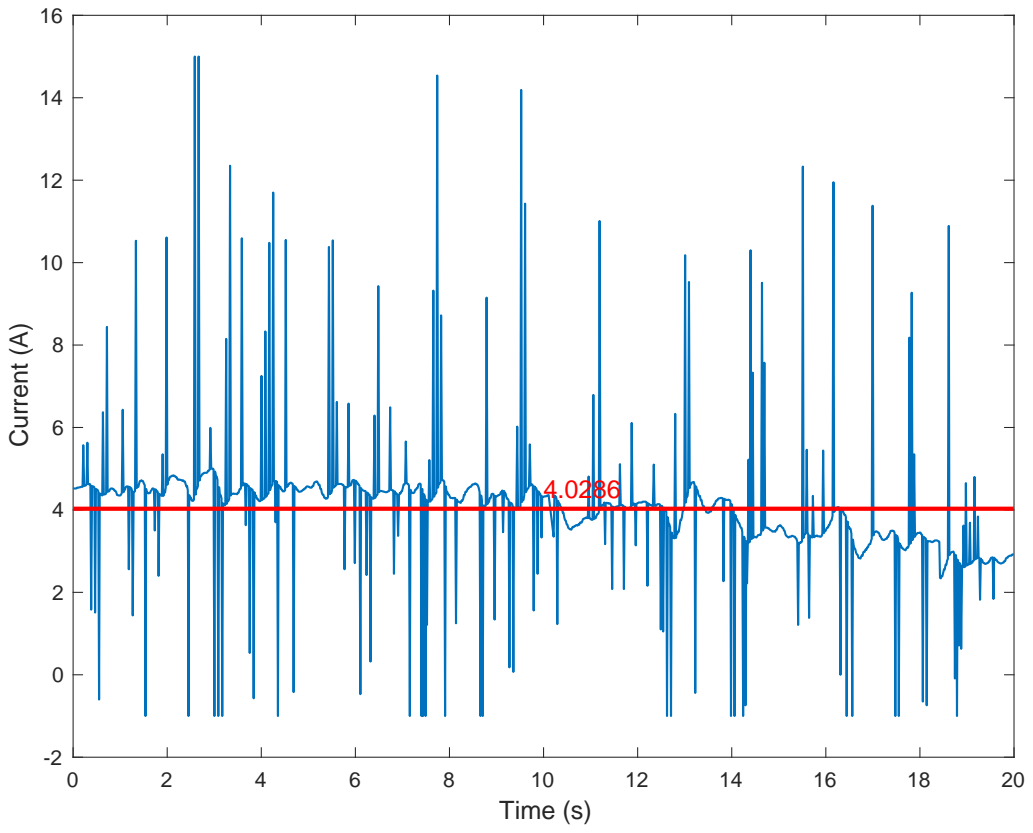
[picture p50: page 1]
Time (s); Current (A)
