pab47/RoadRunner2/Simulation/straight_walk_sim_expt/results/pitch.pdf

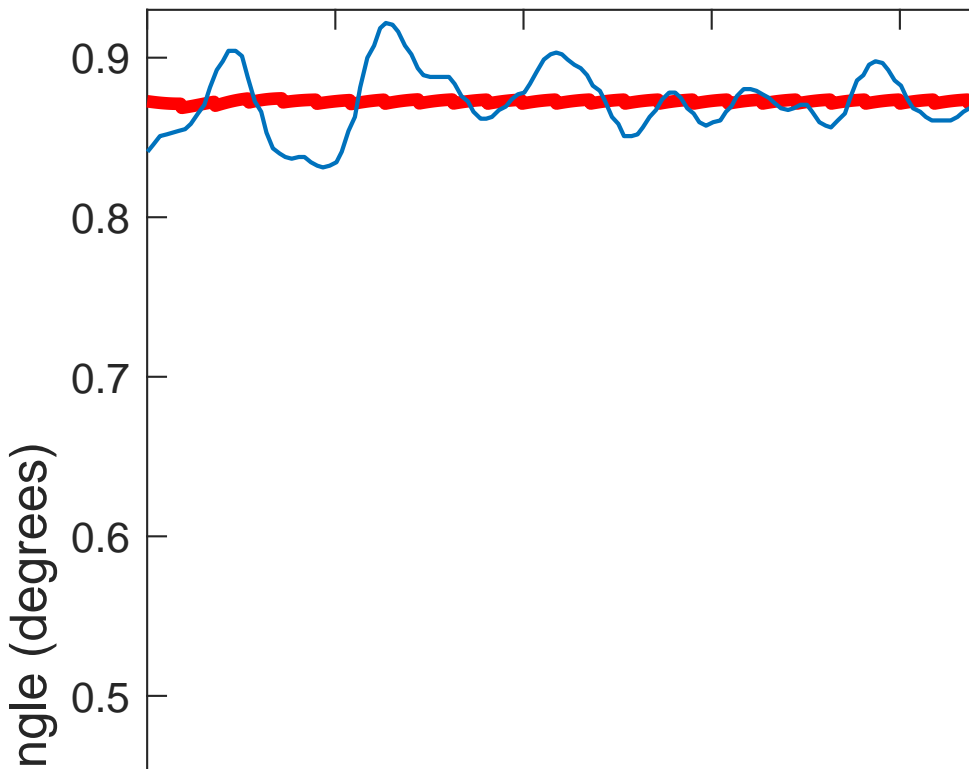
[picture p51: page 1]

Torso pitch angle (degrees)
