pab47/RoadRunner2/Simulation/straight_walk_sim_expt/results/power.pdf

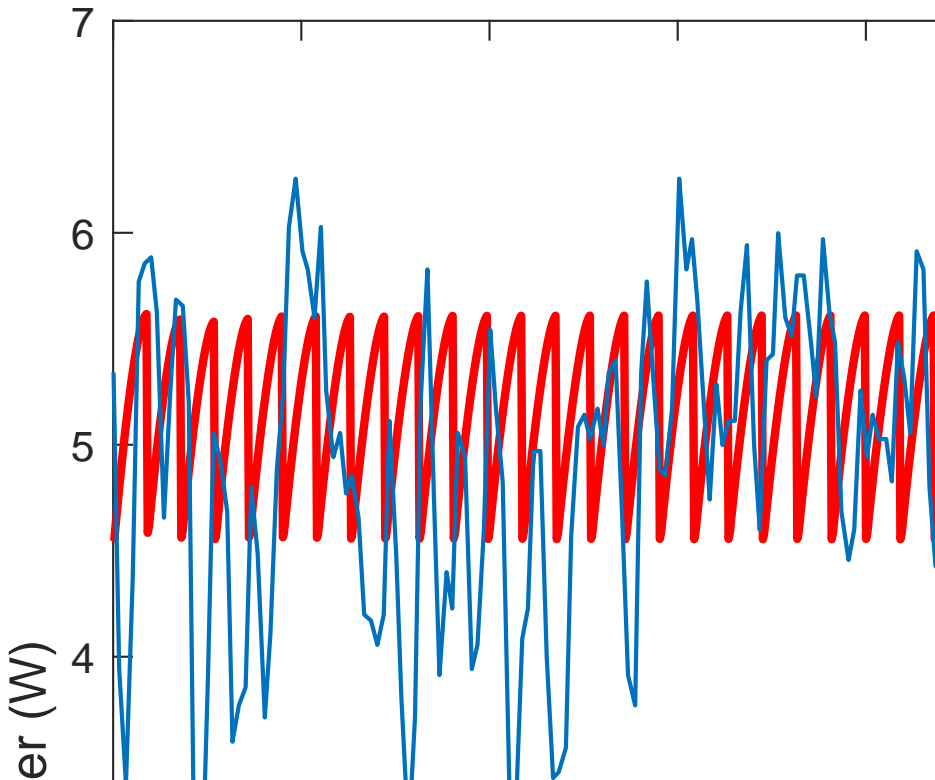
[picture p52: page 1]
Power (W)
