pab47/RoadRunner2/Simulation/straight_walk_sim_expt/results/torque.pdf

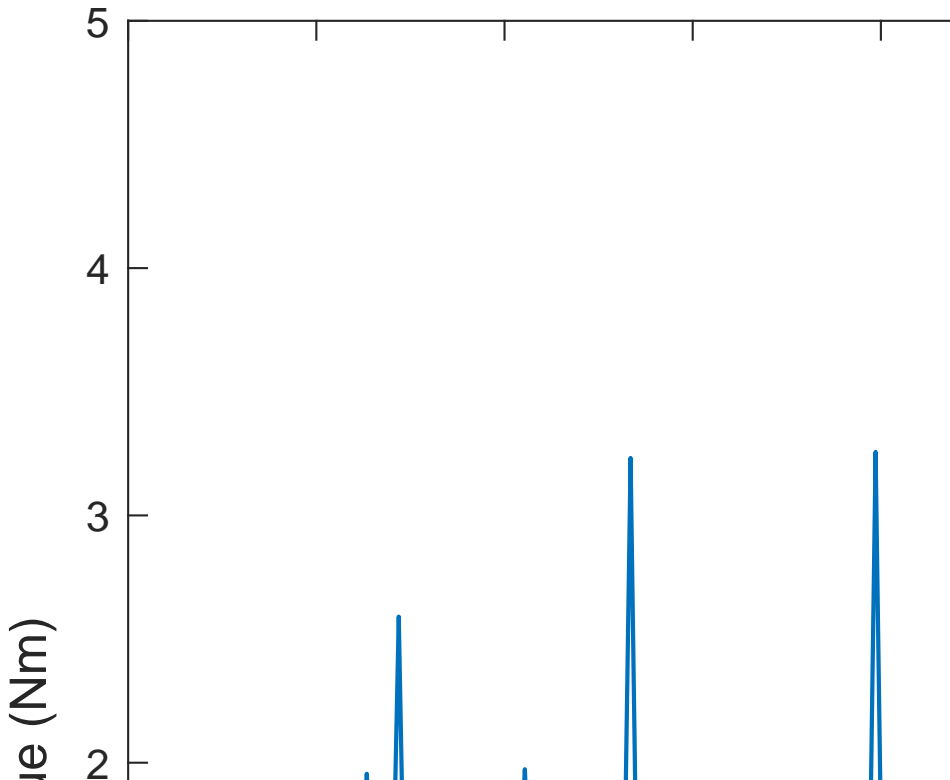
[picture p53: page 1]
Torque (Nm)
