pab47/RoadRunner2/Simulation/turning_walk/results/cartesian.pdf

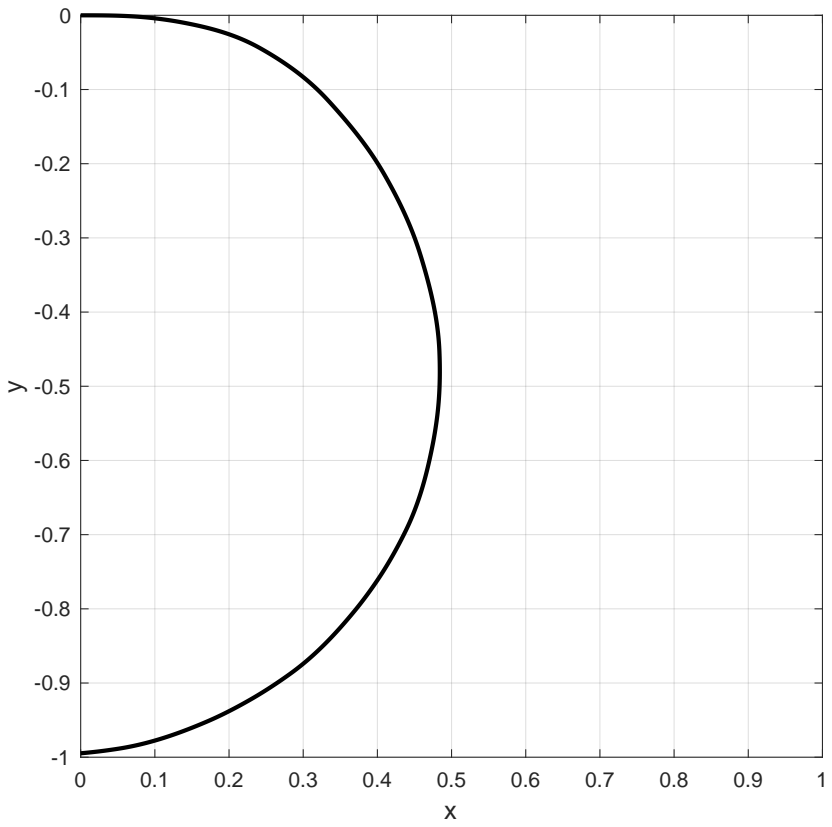
[picture p54: page 1]
