pab47/RoadRunner2/Simulation/turning_walk/results/torso.pdf

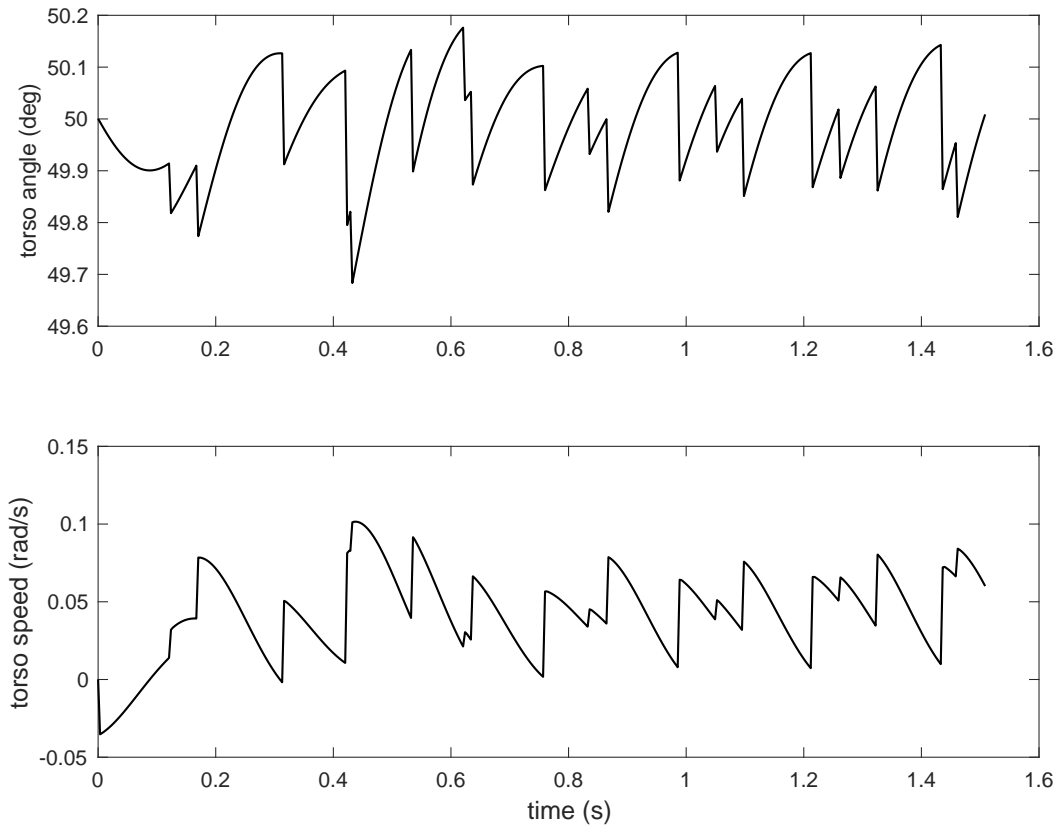
[picture p55: page 1]
time (s)

torso angle (deg)

torso speed (rad/s)
