pab47/RoadRunner2/Simulation/turning_walk/results/wheel.pdf

-0.20

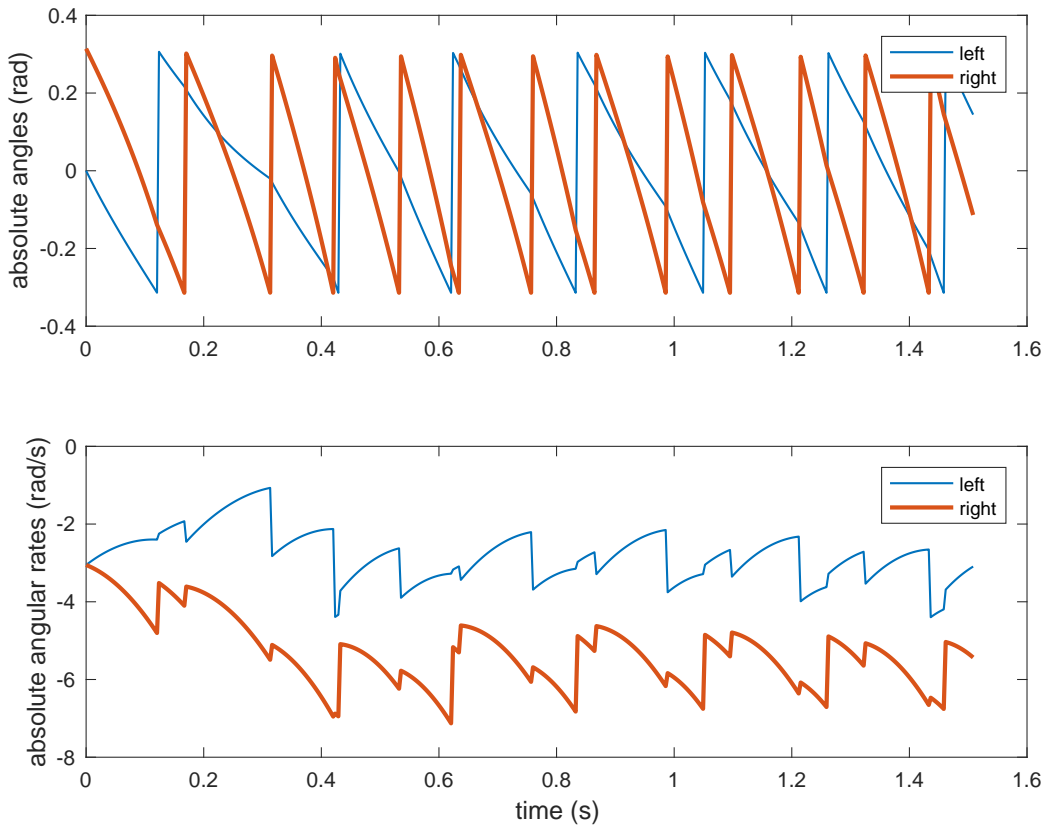
[picture p56: page 1]
left right; time (s)

absolute angles (rad)

absolute angular rates (rad/s)
